RaspPiGuy/Steam-Junction-Room-Of-Sound/First Stage - Proof Of Concept/ESP8266 and MPU9250 - Server.pdf

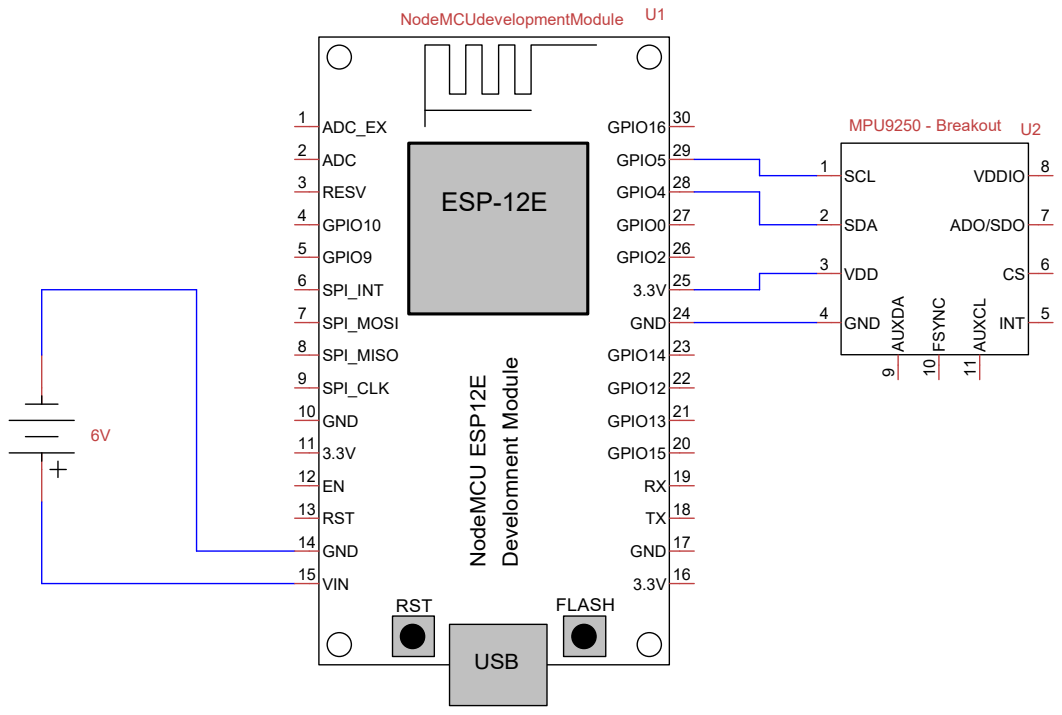
[picture p2: page 1]
VDDIO 8; ADO/SDO 7; INT 5; SCL 1; SDA 2; VDD 3; GND 4; AUXDA; 9 FSYNC 10 AUXCL 11; MPU9250 - Breakout U2; ADC_EX 1; ADC 2; RESV 3; GPIO10 4; GPIO9 5; SPI_INT 6; SPI_MOSI 7; SPI_MISO 8; SPI_CLK 9; GND 10; RST 13; GND 14; VIN 15; GND 17; GPIO15 20; GPIO13 21; GPIO12 22; GPIO14 23; GND 24; GPIO2 26; GPIO0 27; GPIO4 28; GPIO5 29; GPIO16 30 NodeMCU ESP¹²E; USB; RST; FLASH; ESP-12EDevelomnent Module; NodeMCUdevelopmentModule U1

Title
ESP8266 and MPU9250 - SERVER
Author
M. Lyon
Room Of Sound

File | Document

Revision 1.1 | Date August 1, 2017 | Sheets 1 of 1
