RaspPiGuy/Steam-Junction-Room-Of-Sound/Second Stage - Making Sounds/ESP8266 Client to TeensyLC.pdf

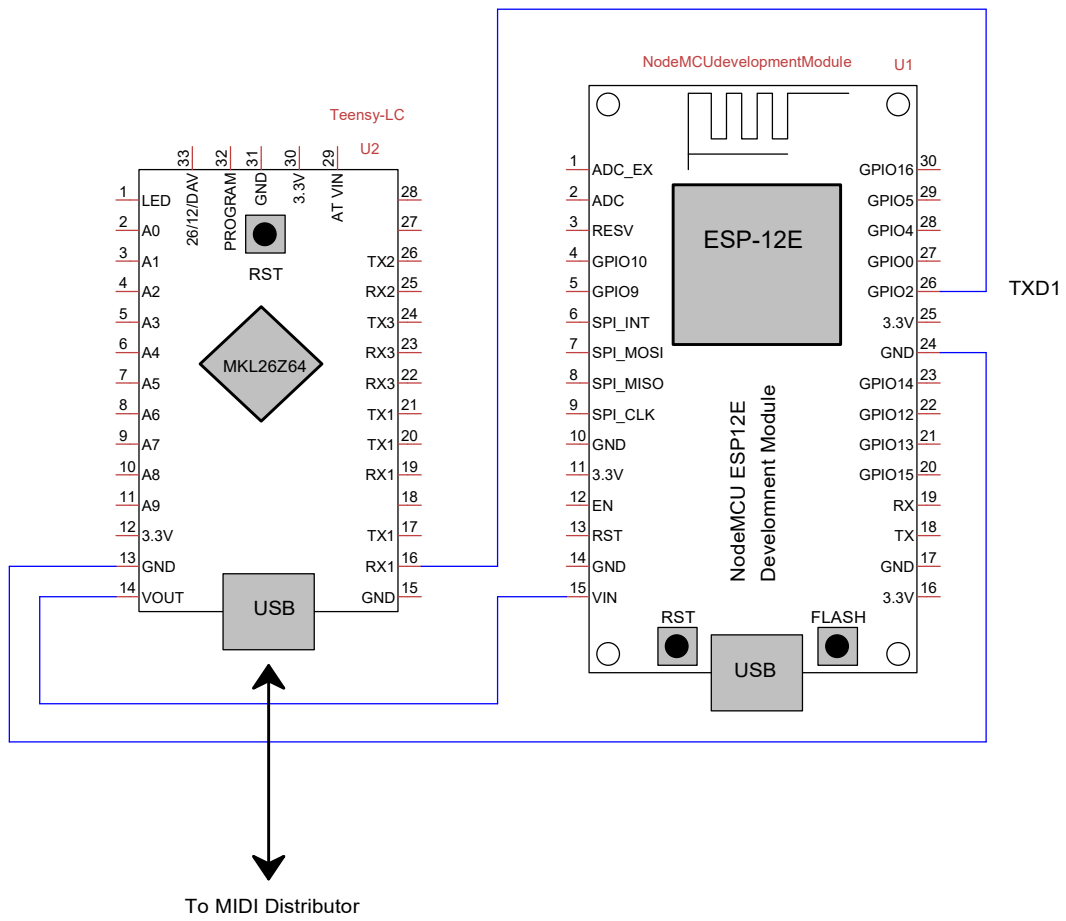
[picture p3: page 1]
ADC_EX 1; ADC 2; RESV 3; GPIO10 4; GPIO9 5; SPI_INT 6; SPI_MOSI 7; SPI_MISO 8; SPI_CLK 9; GND 10; RST 13; GND 14; VIN 15; GND 17; GPIO15 20; GPIO13 21; GPIO12 22; GPIO14 23; GND 24; GPIO2 26; GPIO0 27; GPIO4 28; GPIO5 29; GPIO16 30 NodeMCU ESP¹²E; USB; RST; FLASH; ESP-12EDevelomnent Module; NodeMCUdevelopmentModule; LED 1; GND 13; VOUT 14; GND 15 USB; AT VIN ²⁹ 3.3V ³⁰ GND ³¹ PROGRAM ³² 26/12/DAV ³³; MKL26Z64; Teensy-LC; TXD1

To MIDI Distributor

Title
ESP8266 Client To Teensy
Author
M. Lyon
Rooml Of Sound

File | Document

Revision 1.0 | Date August 1, 2017 | Sheets 1 of 1
