RaspPiGuy/Steam-Junction-Room-Of-Sound/(commit log)

2017-07-21 Proof Of Concept - Midi Input Device
2017-08-02 Changed Repro Name, Added Second Stage, Changed directory structure
2017-08-02 Added Second Stage Video
2017-08-16 Added Accelerometer Position To Sound Production
